jeff-burright/Autopilot_ESP32_wifi/documentation/AP HTML interface(1).png

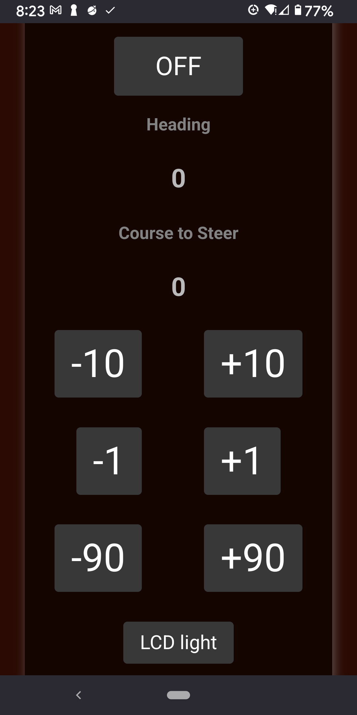
documentation/AP HTML interface(1).png
