jeff-burright/Autopilot_ESP32_wifi/documentation/apbox3d2.jpg

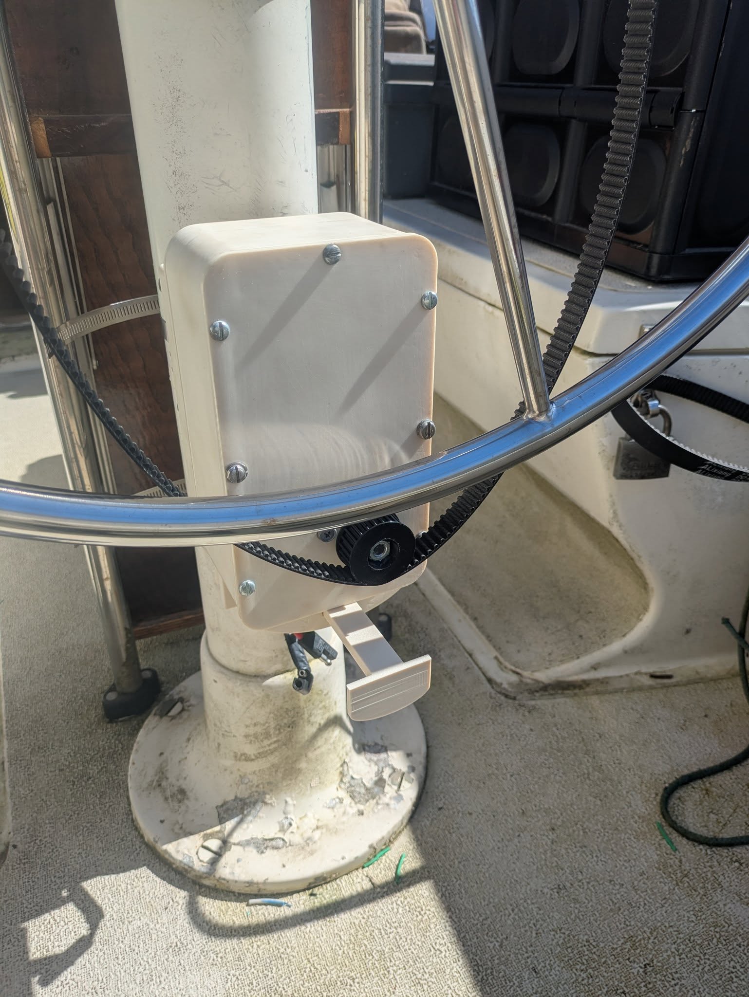
documentation/apbox3d2.jpg
