jeff-burright/Autopilot_ESP32_wifi/documentation/apbox3d.jpg

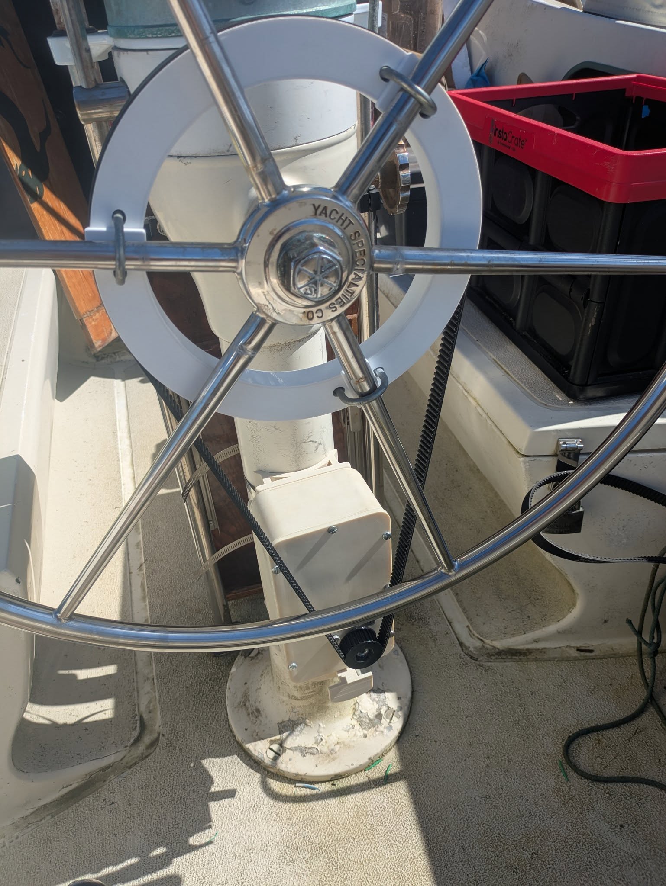
documentation/apbox3d.jpg
