jeff-burright/Autopilot_ESP32_wifi/(threads)

Thread 6 (2024-02-19):

tilt compensation

vgla, 2024-02-19:
### Discussed in https://github.com/jeff-burright/Autopilot_ESP32_wifi/discussions/5

<div type='discussions-op-text'>

<sup>Originally posted by **vgla** February 19, 2024</sup>
Hello Jeff,

Thank you so much for your excellent work.

I installed your code on an esp32 and it works but I'm still having issues with the tilt correction. As soon as I tilt the compass, the heading is changing by a lot (+/- 40°)! Do you have an idea how I should adapt the code? I have an LSM303/L3G 9-axis compass chip (https://www.ebay.com/itm/202091223251) and I calibrated my magnetometer using the calibration code from Polulu. I also tried to adapt the gravity value using the raw measurements from the L3G exemple (serial script).

Thank you again!</div>

jeff-burright, 2024-02-20:
Hi, sorry to hear it's giving you trouble. I was just testing my prototype and am seeing the same issue when the lettering on the IMU is facing up, but when it's facing down the tilt compensation seems to be functioning as long as I don't tilt past 90 degrees on the X or Y axis. By chance do you notice the same behavior? I wonder if I need to work in some absolute value conversions to the tilt compensation equation.

A few other basics to rule out: When you calibrated the magnetometer and got a set of min/max values from the sketch, did you put those values into the pilot's main .INO file, starting at line 296? Also, are you orienting the IMU along the Z axis in its resting state (i.e., laying the chip flat on a table far away from interference sources?

The tilt compensation code is at the bottom of the Compass.ino file for reference, but you shouldn't need to touch it. The heading reading value for the pilot is set as heading=Mag_Heading_Degrees in the Subs.ino tab. This value converts the tilt compensation Mag_Heading value in the Compass.ino tab into degrees for displaying in the UI.

jeff-burright, 2024-02-22:
Update to this. I've uploaded an updated Compass.ino file that I have confirmed has functional tilt compensation *IF* the LSM303 chip is oriented face-down. I've tried all manner of variations I can think of to make it work when the lettering faces up too, but for today it is beyond me. Please try this updated code and tell me if it works for you like it's working for me.

jeff-burright, 2024-02-25:
All right, you drive a hard bargain. I've now uploaded a new version with an entirely different method of calculating heading and tilt compensation. It appears to work for me so long as the Z axis of the IMU is along the horizon plane. Please give it a try and let me know if it works for you.

NOTE: After you get the min/max values for your IMU from the calibrate.ino sketch, those values must be input into Lines 104-105 of the I2C tab in the pilot code.

jeff-burright, 2024-02-26:
Update to this: I've added the option to switch between my original tilt compensation method and a method using the LSM303 library's method, augmented with gyro drift correction. If you go to Line 59 of the main .INO tab, you can input a 0 or 1 after #define LSMLib to switch between the two methods. I've found that my original tilt compensation method works fine for me when the IMU is oriented face-down, so I prefer to keep it an option.

The LSM library method seems to work if the chip is upside down or rightside up, but I'm finding that it can start to drift if you spend too long on a high tilt. In the version uploaded, I default to the original method ("0").

svdrummer, 2025-03-24:
Just for clarity, "face down" means component side down(the face) or PCB side down?
Thank you.

jeff-burright, 2025-03-24:
Components and text down. It'll be pretty easy to tell once you have it
hooked up and are viewing the realtime heading on the HTML.

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

Thread 9 (2025-01-04):

Porting to CodeCell

navado, 2025-01-04:
[CodeCell](https://microbots.io/products/codecell?variant=49714638782797) is tiny orientation sensor fusion board based on ESP32C3. Is it possible to fit autopilot code into this device and have enough compute power for reliable operation?

jeff-burright, 2025-01-04:
Hi, based on the specs I think it would run my code just fine, but you would have to figure out the onboard compass IMU. It shouldn't be too hard to change the IMU library from the LSM303 to the BNO55, and I assume the onboard IMU is already connected to the I2C inputs so you'd just need to make sure you've identified the registers correctly (I think). The question I'd have is what is the benefit to you? It looks like the little chip costs 30 euros with no battery, whereas a devkit + separate IMU can be had for less. You would still need to connect a power cable and the IBT-2 motor controller, which is not small, so I don't think you'd really be gaining much.

If you look at my parts list documentation, you can find a picture of an autopilot I made using a standard devkit and a separate IMU, and both fit together in a small prescription bottle strapped under my cockpit. I then have wires going to the boat's 12V system and the IBT-2, which is located elsewhere in the boat. I don't think this integrated chip would buy you much smaller of a form factor, but maybe there are other benefits I'm not considering?

Closed 2025-02-02.
