jeff-burright/Autopilot_ESP32_wifi/(commit log)

2023-01-21 Add files via upload
    Rebuilt with a LSM303 compass on the GY-511 board. Heading now updates every 3 seconds without needing refresh. This version will work with just the ESP32, IMU compass, and IBT-2 motor controller using HTML interface over wifi for display and control.
2023-01-21 Delete Autopilot_JDB_ESP32_2.ino
    Replaced by version running GY-511 compass board
2023-03-06 Multiple updates
    -- Added PID, deadband, and magvar adjustable settings to user interface
    -- Added rudder position indicator to HTML for purposes of calibration
    -- Activated rudder position code in PID tab for use with a basic rudder position indicator
    -- Restored tilt-compensated compass code (didn't work on GY-511 compass but does work on other 9-axis models)
    -- Added simplistic "dodge mode" (still to test) to allow direct button control of motor from HTML interface
    [AP_Loop.ino, I2C.ino, Keypad.ino, PID.ino, Subs.ino, WiFi.ino]
2023-03-06 added link for linear actuator (tiller variant)
2023-03-27 Updated parts list and included assembly notes
2023-09-18 Shows the new rudder position indicator
2024-02-22 tilt compensation
    Tilt compensation still a little buggy, but this version works IF the LSM303 chip is oriented face-down.
    [Compass.ino]
2024-02-22 tilt compensation fix, wifi AP fix
    [AP_Loop.ino, Compass.ino, LEDdisp.ino, Subs.ino]
2024-02-26 Line59: option to switch between tilt comp methods
2024-02-27 #define LSMLib to switch between tilt comp method
    Look for #define LSMLib in the main Autopilot.INO tab to switch between tilt compensation using the original method vs. the LSM303 library with gyro drift correction. In my opinion, the original method is more stable so long as the IMU chip is oriented facing down.
    [I2C.ino]
2024-06-24 library package
    Includes all libraries not automatically included with Arduino IDE and ESP32. Extract these folders and drop them directly into the Arduino/libraries folder on your computer.
2025-08-08 fixed error in PID setting change via html
    [Keypad.ino, PID.ino, PIDtiller.ino, Subs.ino, WiFi.ino]
2026-02-01 Updated ESP32 Core from 2.1.2; updated libraries
    Note: you still need to make the change to the asyncwebserver file described in the readme, and you also need to make this change to fix a library issue in the new ESP32 Core:
    In cores\esp32\IPAddress.h, replace:
    cpp
    const IPAddress INADDR_NONE(0,0,0,0);
    with:
    cpp
    const IPAddress IP_ADDR_NONE(0,0,0,0);
    [PID.ino, WiFi.ino]
2026-02-01 Rudder low pass filter; IMU installation correction
    Added a low pass filter to the main.ino tab and PID tab. Added new user defined term for IMU installation orientation to sync up the boat's compass with the IMU compass reading.
    [PID.ino, Subs.ino]
2026-05-12 rudder hall sensor fix
    Instructs hall sensor to turn off and on again after startup to fix incorrect initial calibration.
    [Autopilot_ESP32_2.1.ino, PID.ino]
