jeff-burright/Autopilot_ESP32_wifi/(notices)

Notices in the files:
DCM.ino:
under the terms of the GNU Lesser General Public License as published by the
Free Software Foundation, either version 3 of the License, or (at your option)
